DCC-Lab/HiLoZebrafish/README.md

# HiLoZebrafish
Image acquisition system for volumetric calcium imaging
