DCC-Lab/HiLoZebrafish/TODOlist/Semaine6 - 10au15 juin 2019.md

Maxence : 
  - Ajouter un polariseur entre le diffuseur et la fibre. FAIT! (MAIS il est rayé donc on devra le remplacer)
  - Aligner l'illumination. FAIT!
  - Vérifier ce qui ne fonctionne pas avec le code à Dan (Pourquoi on arrive pas aux mêmes chiffres? Est-ce qu'il nous manque des infos?) 
  - Est-ce que le diffuseur a un angle assez grand pour couvrir tout le champ de vue? Diffuseur N-BK7 a un angle d'environ 5 degrés (FWHM). Caractériser le diffuseur (Diffuser transmission VS Output Angle)
  - Comparer des images prises avec un diffuseur de 600 et 1500 grits.
  - Comparer l'illumination entre différentes distances entre la fibre et le diffuseur. Faire un graphe. (si possible)
  - Images de billes fluorescentes 
  - Optimiser le couplage entre le faisceau laser et la fibre multimode FAIT!

Valérie : 
  - Rassembler les informations sur le *Laser Speckle Remover* d'Optotune. Faire un document récapitulatif. Pas fait de document, mais la lecture est faite. 
  - Lire le code à Guillaume.
  - Investiguer sur l'apparence des images sur Nirvana VS sur Fiji #isjustImageJ qui n'est pas la même. FAIT! 
  - Aller prendre sa photo pour sa carte d'accès. FAIT!
  - Acheter deux polariseurs FAIT!
  - Lire sur la TF (Documents à Max) FAIT!
  
Lectures : 
  - Miniaturized Laser Speckle Reducer OEM Series : https://www.optotune.com/images/products/Optotune%20LSR-OEM.pdf
  - Application note, Laser speckle reduction with Optotune’s laser speckle reducer LSR-3000 & LSR-OEM : https://www.optotune.com/images/products/Optotune%20application%20note%20LSR.pdf
  - Dynamic speckle illumination microscopy with translated versus randomized speckle patterns, Jerome Mertz
