DCC-Lab/HiLoZebrafish/TODOlist/Semaine4-27mai2019.md

À COMMANDER : (VPN)
  - EXFO 810-00032 Collimating adaptor S/N : DH1437
  
TODO :
 - Trouver la focale selon le mvt de la lentille Optotune (ML)
 - Optotune avec un diametre plus gros? Voir sur le site, rassembler les infos + lire manuel d'instructions avec les commandes and all (VPN)
 - Faire fonctionner la lentille optotune : Aller voir Steve si on peut réparer la USB len driver, trouver le cube beige dans le lab (?). Est-ce qu'on est mieux d'en commander une autre ou de faire un software maison? (VPN)
 - Essayer de patenter un excelitas maison pour commencer à regarder comment a l'air l'illumination (ML)  FAIT
 - Taponner les poissons (VPN et ML)
 - Trouver lentille divergente pour Optotune (J'ai trouvé une de f = -75 mm) + tester si la lentille fonctionne (ML)
