DCC-Lab/HiLoZebrafish/TODOlist/Semaine3-21mai2019.md

À COMMANDER : (VPN)
  - EXFO 810-00032 Collimating adaptor S/N : DH1437
  - 4 cables WilcoImaging RW1LX17-2.0 2 meter standard to mini camera to link cable. : FAIT 22 mai 2019
  - Carte (Alicja va envoyer infos) : FAIT 22 mai 2019

TODO : 
  - Laser PySerial (#PyCereal) truc (ML)
  - Abstract SN a envoyer (VPN)
  - Contrôler directions yx avec Mac (VPN)
  - Trouver la focal selon le mvt de la lentille (ML)
  - Trouver lentille divergente pour Optotune + tester (ML)
  - Optotune avec un diametre plus gros? Voir sur le site, rassembler les infos + lire manuel d'instructions avec les commandes and all (VPN)
  - Patenter l'illumination (ML)
