DCC-Lab/HiLoZebrafish/TODOlist/Semaine 15 - 12 août 2019.md

Mini setup : 
- Faire expérience sur l'angle de diffusion du diffuseur DG10-120 et DG10-220. Mettre dans un graphe avec les autres diffuseurs (DG10-600 et DG10-1500) *120 fait!!*
  - Calculer le diamètre théorique avec les NA obtenus. 
- Mesurer le diamètre et la taille moyenne des speckles selon les fibres 0.22 et 0.5 NA et les diffuseurs 120 et 1500. 
  - Modifier le setup pour avoir des lentilles plus grosses *ne fonctionne pas avec des 2 pouces, focal trop grosse*
  - Rapprocher la fibre du diffuseur, produire un spot plus petit au diffuseur. *ne fonctionne pas!*

Maxence : 
  - Présentations de 5 et 15 min à préparer (pour jeudi)
  - Commencer le rapport de stage (quoi mettre? diviser en sections?)
  - Documentations 
  - Faire d'autres images HiLo et Widefield de poisson zèbre GCaMP (demander à Vincent Boily)
  
Valérie : 
  - Finir mon affiche SN ! 
  - Je ne suis pas là mardi et mercredi

Bonne semaine :) !!

  ______________________________________________________
   Discussion des speckles avec BLiq : 
 - NA de l'objectif change la taille des speckles sur les images? 
    - Expérience : Mesurer la taille des speckles sur un échantillon de FITC en utilisant 2 objectifs de même grossissement, mais avec des NA différents 
 - Grossissement objectif change la taille des speckles sur les images?
    - Expérience : Mesurer la taille des speckles sur un échantillon de FITC en utilisant 2 objectifs de même NA, mais avec des grossissements différents.
 - Back aperture de l'objectif change la taille des speckles sur les images?
    - Expérience : Comme le diamètre du back aperture de l'objectif varie en fonction du NA et du grossissement, son influence pourra être déduite à partir des deux dernières expériences. Par contre, il est important de s'assurer que le BA des objectifs utilisés lors des expériences sont remplis.
 - Taille plus petites des speckles diminue le flickering?
    - Expérience : Prendre des images d'un échantillon de FITC et de l'échantillon de cellules de rein de Bliq à l'aide d'une fibre de NA de 0.39, de 0.5 et de 0.63. Comparer le flickering observé sur chaque stack.
 - Nombre de grits du diffuseur change le flickering? Comment il le change?
    - Expérience : Prendre des images d'un échantillon de FITC et de l'échantillon de cellules de rein de Bliq à l'aide de diffuseurs de 120, 220 et 1500 grits. Tourner les diffuseurs lors de l'expérience pour observer du flickering. Comparer ensuite le flickering observé sur chaque stack.
  
  ______________________________________________________
  À discuter avec Dan :
  
  - Que ce passe-t-il avec le LSR? Aller voir Bliq
  - Commander un autre objectif? *Une fois que les expérimentations concernant la discussion avec Bliq seront faites et analysées. En discuter avec Daniel*
      - Déterminer quels paramètres affectent la taille des speckles (NA, grossissement, Taille de la pupille d'entrée de l'objectif).
      - Déterminer quels paramètres affectent l'intensité du flickering (Taille des speckles, niveau de grit des diffuseurs).
