DCC-Lab/HiLoZebrafish/TODOlist/Semaine 12 - 22 au 26 juillet 2019.md

Maxence : 
  - Regrouper les informations sur l'optique et rédiger un document informatif. 
  - Expérience sur l'angle du diffuseur DG10-1500 et LSR-3005 : Regrouper les données en tableau, graphe... FAIT!
  - Optimiser la distance fibre-diffuseur (Uniformité vs. Intensité lumineuse à l'échantillon vs. taille des speckles)
  - Connecter le LSR à Nirvana (Par le Labjack) *voir Bertrand*
  - Fabriquer une boîte pour protéger nos yeux des réflexions indésirables du laser FAIT!
  - Graphique du spectre de transmission du LSR, mesuré avec le spectromètre d'Anaïs. FAIT!
  - Tester l'algorithme HiLo avec le même sample, mais aves deux sources d'uniformité différentes (LSR vs. Scrambler) FAIT!
  - Rergarder la grosseur des speckles avec la fibre à Bliq NA = 0.63

Valérie : 
  - Comparer la taille des speckles avec les deux diffuseurs DG10-1500 et LSR-3005. FAIT!
    - Reprendre d'autres images des speckles avec les deux diffuseurs. Meilleurs résultats statistiques! FAIT!
    - Taille théorique? *on pourrait obtenir la plus petite taille théoriqe...*
  - Comment faire l'expérience avec le spot sur le mur? *probablement qu'il va falloir refaire le setup droit*
  - Mesurer expérimentalement la résolution axiale. Comparer avec la valeur théorique (?). 
    *La résolution axiale d'un objectif est dépendante de sa résolution latérale.*
    *Plus petit objet pouvant être discernable par le système optique.*
    *Sectionnement optique ne doit pas être plus petit que la résolution axiale.* 
    *1 neurone = 4-5 um*
  - Commence dont ton affiche pour SN toi chose... 
  - Expérience sur l'illumination avec le LSR dans l'axe optique. Vérifier max gray value et curvature.  

 _______________________________________________________
 
 - Imagerie de poisson zèbre GCaMP sur le 2-photons bessel avec François. FAIT!
 - On est à boutte que Caféine ne fonctionne pas! WE NEED DELTA. FAIT!
 - Aller voir Bertrand avec notre LSR. Tester son fonctionnement. 600 ms pour s'activer! *faut parler à optotune*
 - Prendre des z-stacks avec le piezo électrique. NE SEMBLE PAS FONCTIONNER #malaise
 - Prendre des z-stacks avec le sutter motion controller de Charles. 
 - Transmission du LSR avec le potentiomètre. FAIT!
 - Commander un autre objectif? 
 
 ______________________________________________________
 Discussion des speckles avec BLiq : 
 - NA de l'objectif change la taille des speckles sur les images? 
    - Expérience : Mesurer la taille des speckles sur un échantillon de FITC en utilisant 2 objectifs de même grossissement, mais avec des NA différents 
 - Grossissement objectif change la taille des speckles sur les images?
    - Expérience : Mesurer la taille des speckles sur un échantillon de FITC en utilisant 2 objectifs de même NA, mais avec des grossissements différents.
 - Back aperture de l'objectif change la taille des speckles sur les images?
    - Expérience : Comme le diamètre du back aperture de l'objectif varie en fonction du NA et du grossissement, son influence pourra être déduite à partir des deux dernières expériences. Par contre, il est important de s'assurer que le BA des objectifs utilisés lors des expériences sont remplis.
 - Taille plus petites des speckles diminue le flickering?
    - Expérience : Prendre des images d'un échantillon de FITC et de l'échantillon de cellules de rein de Bliq à l'aide d'une fibre de NA de 0.39, de 0.5 et de 0.63. Comparer le flickering observé sur chaque stack.
 - Nombre de grits du diffuseur change le flickering? Comment il le change?
    - Expérience : Prendre des images d'un échantillon de FITC et de l'échantillon de cellules de rein de Bliq à l'aide de diffuseurs de 120, 220 et 1500 grits. Tourner les diffuseurs lors de l'expérience pour observer du flickering. Comparer ensuite le flickering observé sur chaque stack.
    
_____________________________________________________________

Rapop des 3 dernières semaines : 

  - Tailles des speckles VALÉRIE
    - Expliquerish la méthode employée
    - Résultats avec le DG10-1500 et le LSR.

  - Flickering MAXENCE
    - Pourquoi c'est un problème?
    - Montrer les deux stacks avec le scrambler et le LSR : même flickering. 
      Les causes du flickering seraient donc bouger la fibre et bouger le diffuseur. 
    - Solutions pour régler le problème. 

  - Caractérisation des diffuseurs avec différents grits MAXENCE
    - Montrer les graphes de wtv. 
    
  - Patron d'illumination VALÉRIE
    - Max gray value : Comparaison DG10-1500 VS LSR
    - Curvature : Comparaison DG10-1500 VS LSR 
    
  - Images et vidéo zebrafish BOTH
    - Vidéos d'activité calcique
    - Images HiLo
