DCC-Lab/HiLoZebrafish/TODOlist/Semaine 11 - 15 au 19 juillet 2019.md

Maxence : 
  - Regrouper les informations sur l'optique et rédiger un document informatif. 
  - Comment refaire l'expérience de l'angle du diffuseur? FAIT *avec le stage!*
  - Optimiser la distance fibre-diffuseur (Uniformité vs. Intensité lumineuse à l'échantillon vs. taille des speckles)
    - Trouver la tailles des speckles avec une simulation(?) par régression(?). FAIT !
    - Comparer la taille exprimentale des speckles avec sa valeur théorique (Taille = lambda/2NA)
  
  Valérie : 
    - C'est quoi une simulation par régression? FAIT! *Curve fit* 
    - Comment faire l'expérience avec le spot sur le mur? *probablement qu'il va falloir refaire le setup droit*
    - Mesurer expérimentalement la résolution axiale. Comparer avec la valeur théorique (?). 
    *La résolution axiale d'un objectif est dépendante de sa résolution latérale.
    Plus petit objet pouvant être discernable par le système optique. 
    Sectionnement optique ne doit pas être plus petit que la résolution axiale. 
    1 neurone = 4-5 um*
      Faire de même avec la résolution latérale. FAIT

  - Imagerie de poisson zèbre GCaMP lundi à vendredi. Faire des vidéos d'activité neuronale. 
  - Déterminer l'irradiance *parfaite* pour l'imagerie *in vivo* de poisson zèbre. 
    Utiliser des objectifs avec plus de grossissement si possible. 
    *Utilisé un 40X et le poisson n'a pas cramé. Irradiance = 354.4 mW/mm^2*
    
  Lectures : 
  
    - Statistical speckle study to characterize scattering media: use of two complementary approaches, O. Carvalho and *al*.,  
    - Speckle size, intensity and contrast measurement application in micron-size particle concentration assessment, Dan Chicea
    - Methods for Determination of Mean Speckle Size in Simulated Speckle Pattern, I. Hamarava and *al*.,
    
  Bonne semaine :)!!
