DCC-Lab/HiLoZebrafish/TODOlist/Semaine10 - 8 au 12 juillet 2019.md

Maxence :
  - Regrouper les informations sur l'optique du microscope et rédiger un document informatif.
  - Vérifier ce qui ne fonctionne pas avec le code à Dan (Pourquoi on arrive pas aux mêmes chiffres? Est-ce qu'il nous manque des infos?)
  - Est-ce que le diffuseur a un angle assez grand pour couvrir tout le champ de vue? *Caractériser le diffuseur (Diffuser transmission VS Output Angle) *Recommencer l'expérience faite avec un écran blanc, mon téléphone et une règle pour plusieurs distances diffuseur-écran.* FAIT! Les résultats montre que l'expérience ne fonctionne probablement pas
  - Comparer des images prises avec des diffuseurs de 120, 240, 600 et 1500 grits quand on les reçoit. FAIT! *Reste plus qu'à voir qu'est-ce qu'on peut en tirer
  - Optimiser la distance fibre-diffuseur (Uniformité vs. Intensité lumineuse à l'échantillon vs. Taille des speckles)
    - Trouver la taille des speckles avec une simulation par régression *quoi? pardon?*
    - Caractériser/Trouver les speckles avec un objectif 40X/60X etc.
  - Image poisson avec un objectif plus gros, permet d'augmenter (40X) l'irradiance. Déterminer l'irradiance ''parfaite'' pour l'imagerie *in vivo*. *Semaine prochaine!*
  
Valérie : 
  - Faire un film d'activité neuronale d'un plan dans un zebra vivant. 
  *Penser essayer avec le 20X et le 40X. Semaine prochaine!*
  - Faire l'expérience sur la grosseur du spot au mur 
  *Ne fonctionne pas en mettant un miroir pour faire dévier le beam, car beam trop gros. On doit le garder droit. Comment faire un set-up stable?*
  - Mesurer expérimentalement la résolution latérale et axiale. Latérale = FAIT!
  - Faire une slide de beads fluorescents pour mesurer les objets dans nos images + scalebar. FAIT! 
  - Extraire le maximum des données de curvature. FAIT! 
  *Mais il n'y a pas de plateau... comment interpréter ces résultats? Déterminer la distance optimale aussi avec la grosseur optimale de speckles ; pas juste avec la puissance à l'échantillon. Quelle sectionnement optique est l'idéal?*

Bonne semaine! :)
