DCC-Lab/HiLoZebrafish/TODOlist/Semaine8 - 25 au 28 juin 2019.md

Maxence :

- Vérifier ce qui ne fonctionne pas avec le code à Dan (Pourquoi on arrive pas aux mêmes chiffres? Est-ce qu'il nous manque des infos?)
- Est-ce que le diffuseur a un angle assez grand pour couvrir tout le champ de vue? Diffuseur N-BK7 a un angle d'environ 5 degrés (FWHM). Caractériser le diffuseur (Diffuser transmission VS Output Angle) (L'expérimentation est faite, voir avec Daniel si elle est assez rigoureuse)
- Comparer des images prises avec des diffuseurs de 120, 240, 600 et 1500 grits.
- Optimiser la distance fibre-diffuseur (Uniformité VS Intensité lumineuse à l'échantillon)
- Commander le piezo. (Le message a été envoyé à Daniel, car Julie est en congé)
- Voir avec Vincent, Radu et Gabriel : Quelle puissance utilise-t-il avec leur 2ph pour imager? Peut-être qu'on a besoin de plus de puissance finalement... (Microscope with illuminator HXP 120V => ~ 14.41 mW at the sample)
- Réussir à se connecter à cafeine2

Valérie :

- Ajouter une lentille pour observer l'image de la source lumineuse au diffuseur. Obtenir le diamètre de la source. 
- Pourquoi on a autant d'artifact de fluorescence dans les images de zebrafish? Investiguer... 
- Vérifier les filtres. Peut-être qu'ils n'ont pas une bonne transmissivité ou wtv. (En effet, on a besoin d'un autre filtre! Changé pour le D545\90)
- Refaire l'expérience de la distance entre le diffuseur et la fibre avec moins d'exposure time (avec et sans polariseur). Faire un curvefit éllipse et vérifier la pente de la courbe. Pente élevée = illumination moins uniforme. (Pas si évident que ça à voir dans les courbes de slopes d'illumination. Comment faire pour savoir quelle est la bonne distance?)
- Scalebar avec des billes de 1um! (Faut refaire une lame de billes, car les billes sont en agrégats sur notre lame.)
- Vérifier des images de poissons sans binner et en intégrant plus longtemps pour avoir des neurones plus définis. Aussi, comparer les images prises avec et sans speckle. Jusqu'à maintenant, les images étaient toujours prises avec speckle! (Pas évident de voir la différence entre les deux images...)
- Faire une présentation pour Jeudi FAIT!
