DCC-Lab/HiLoZebrafish/TODOlist/Semaine7 - 17 au 21 juin 2019.md

Maxence : 
  - Vérifier ce qui ne fonctionne pas avec le code à Dan (Pourquoi on arrive pas aux mêmes chiffres? Est-ce qu'il nous manque des infos?)
  - Est-ce que le diffuseur a un angle assez grand pour couvrir tout le champ de vue? Diffuseur N-BK7 a un angle d'environ 5 degrés (FWHM). Caractériser le diffuseur (Diffuser transmission VS Output Angle)
  - Comparer des images prises avec un diffuseur de 600 et 1500 grits et les autres grids
  - Investiguer pourquoi il y a autant de pertes au diffuseur et au polariseur FAIT!
  - Voir si l'adapteur (nose-piece) de l'objectif fait en sorte que l'on perd de la puissance FAIT!
  
Valérie : 
  - Faire fonctionner le stage avec le software. FAIT! 
  - Commander les autres grids FAIT! 
  - Comparer l'illumination entre différentes distances entre la fibre et le diffuseur. Faire un graphe. (si possible)
  
Lecture : 
  - Optimizing and extending light-sculpting microscopy for fast functional imaging in neuroscience (2015)
  
IMAGE POISSON :)
