DCC-Lab/HiLoZebrafish/TODOlist/Semaine2-16mai2019.md

À COMMANDER (VPN) :
  - diffuseur DG10-1500 : https://www.thorlabs.com/thorproduct.cfm?partnumber=DG10-1500 Fait!
  - objectif UMPLFN 20X : https://www.olympus-lifescience.com/en/objectives/lumplfln-w/#!cms[tab]=%2Fobjectives%2Flumplfln-w%2F20xw Fait!
  - Olympus U-TLU + U-CMAD3 + U-TV1X-2 : Adaptateur pour le BX51 et la cam Orcaflash : Fait!
  - Thunderbolt 3 à 2 apple : Fait! 

À TROUVER (ML) : 
  - Caméra Orcaflash : Fait! Chez Bliq
  - Adapteur pour BX51 (on aurait juste besoin d'un diffuseur? voir mardi et mercredi prochain avec Alicja)
  - Power supply pour la boîte d'acquisition : Fait! Est sur la table optique.
  - Camera link bouts gros et petit : Fait! 

TO-DO : 
  - Abstract SN affiche (VPN)
  - Comprendre git (VPN et ML) : ok
  - Demain 17 mai 2019 : Trouver les À TROUVER, aller voir Benoit chez Bliq (ML)
  - Jouer avec le code de l'illuminateur et vérifier qu'on a toutes les lens (ML). FOV = 600 X 600 X 300
    - Semaine prochaine : Concevoir l'illuminateur (ML)
  - Vérifier le code MatLab à François pour le scrambler (code sur Git) (ML)
  - Contrôler directions xy avec ordi (VPN)
  - Comment contrôler la lentille et rassembler des infos sur la lentille (VPN)
  - Trouver le f selon le mouvement de la lentille (ML)
  - Semaine prochaine : Synchroniser l'acquisition et le mouvement de la lentille/vérifier comment l'acquisition se fait avec Nirvana (parler à François pour installer Nirvana sur l'ordi en-bas)
    (VPN et ML)
