DCC-Lab/HiLoZebrafish/MarcStageEte2023/cahier_de_lab/week2/20230511/20230511.md

# Présence en laboratoire le 11 mai

## Expérience 1

## But principal

___

Le but de cette présence en laboratoire était de mesurer la taille moyenne des *speckles* avec le microscope HiLo pour caractériser leurs tailles en fonction de la taille de l'image prise. Nous voulions savoir si le critère de Nyquist était respecté pour ces différentes tailles. Nous avons mesurés leur taille en pixel pour les tailles d'images suivantes: 2048x2048, 1024x1024 et 512x512. L'échantillon sur lequel les mesures furent prises fut un tapis de billes fluorescentes.

## Matériel

___

- La caméra utilisée est la ORCAFlash4.0 V3 - C13440-20CU, une caméra digitale CMOS de *Hamamatsu*. Les notes techniques sont disponibles [ici](https://www.hamamatsu.com/content/dam/hamamatsu-photonics/sites/documents/99_SALES_LIBRARY/sys/SCAS0134E_C13440-20CU_tec.pdf) et le manuel d'instruction [ici](https://seltokphotonics.com/upload/iblock/d68/d6870f763aa81b7b8f2c0853b7e20782.pdf)

- Le logiciel qui permet de contrôler la prise d'image et les différents paramètres de la caméra est: *NirvanaS* (2.4.1). Les différentes fenêtres et options qui seront utiles dans cette expérience sont expliquées dans un guide pour l'utilisation du microscope HiLo disponible [ici](fakelien.com).

- Un laser pour permettre la fluorescence et donc la possibilité de visionnement d'image. On utilise le *Cobolt* 06-MLD 488nm de *HÜBNER Photonics*. La *data sheet* est disponible [ici](https://hubner-photonics.com/wp-content/uploads/2014/11/D0352-O-Datasheet-Cobolt-06-01-Series.pdf) et l'explication de son utilisation avec notre système optique ce trouve [ici](fakelien.com).

- Lame et lamelle de microscopie

- Vernis à ongle

- Pipette volumétrique P200 et P20 avec les embouts leurs correspondant.

- Solution contenant les billes fluorescenctes: *Rhodamin 6G* (RG6).

- Eau distillée (Milli-Q)

## Méthode

___

Cette expérience sera divisée en 3 étapes distinctes:

- $(1)$ **Premièrement**: Préparer des échantillons de bille fluorescente (RG6) pour pouvoir observer la taille des *speckles* sur ceux-ci.

- $(2)$ **Deuxièmement**: À différentes tailles d'images, prendre une photo de l'échantillon de RG6 préparé pour pouvoir analyser ces images numériquement et en tirer la taille des *speckles* par la suite.

- $(3)$ **Finalement**: Utiliser les images prises pour estimer numériquement la taille des *speckles* en fonction de la tailles des images pour pouvoir savoir si la taille des *speckles* respecte toujours le critère de Nyquist.

## Déroulement

___
Étape $(1)$:

- Méthode prise:

  La méthode pour préparer les échantillons est celle qui est expliqué dans la *repository GitHub* [suivante](https://github.com/DCC-Lab/Documentation/tree/master) sous le dossier *HOWTO* -> *.HOWTO-MeasureMeanSpeckleWidthOnInFocusImagesOfSpeckles.pdf*. Dans ce document, seule la partie de préparation d'échantillon nous intéresse.

  Dans notre cas, la solution de bille que l'on utilise est de la *Rhodamin 6G* (RG6) diluée 2 fois avec de l'eau distillée Milli-Q. On a donc préparé une solution contenant $400 \mu L$ de *RG6* et $400 \mu L$ de Milli-Q. Par contre, sur la lamelle, on a seulement déposé 2 fois $20\mu L$ de cette solution, donc $40\mu L$.

Étape $(2)$:

- Branchement des différents appareils utilisés:

  Comme d'habitude, on ouvre le système de microscopie HiLo suivant le guide donné plus haut dans la section **Matériel**.
  
  Dans le cas de cette expérience, le changement de focale se fera en bougeant manuellement le *stage* qui tiens l'échantillon en place.

- Setup logiciel:

  Le setup logiciel de cette expérience est selon la procédure standard, toujours expliqué dans le guide HiLo.
  
  Dans le cas de cette expérience, rien n'est différent du guide, mis-à-part le fait que l'on doit s'assurer d'avoir le module *TimeLapse* ouvert, car il s'avèrera grandement utile pour une prise des données rapide.

- Méthode prise:

  La taille des *speckles* se calcule uniquement au plan focal de l'échantillon. On doit donc prendre une image à ce plan focal pour obtenir une dimension réaliste. Par contre, ce plan focal est arbitraire, car on le détermine simplement à l'oeil. Pour s'affranchir de ce problème, on peut prendre plusieurs images autour de ce qu'on pense être le plan focal et réaliser l'analyse de la taille des *speckles* pour chacune de ces images. Alors, la taille effective des ces *speckles* sera la valeur obtenue la plus petite, car elle se situera nécéssairement au plan focal.

  Les différentes images qui seront intéressante pour cette expérience sont les suivantes: pour chaque résolution, on veut 10 images de différents plans autour du plan focal, par exemple 5 plus haute que le plan focale et 5 plus basse que le plan focal, en s'assurant qu'elles sont faiblement spatialement espacées (dans notre cas chaque image est espacée de $2 \mu m$). Par la suite, pour déterminer la taille des speckles, on doit aussi prendre une image uniforme et une image speckle pour chaque plan choisi. Cela fait donc 20 images par taille d'image et donc 60 images en tout.

  Pour s'y prendre, on commence par choisir la première résolution. On détermine à l'oeil ce qu'on pense être le plan focal et par la suite on descend (ou monte) le stage 5 plans plus haut. Dans notre cas, on monte le stage $10 \mu m$ plus haut. Ensuite, en commençant pas le mode uniforme par exemple, on prend 10 images en descendant le stage de 10 plans. On refait alors la même chose pour la même taille d'image, mais en changeant pour des images *speckles*. On a alors les 20 images pour la première taille d'image. Finalement, il suffit de refaire la même chose pour les autres tailles d'images.

  Il est bien important d'aller le plus vite possible pour prendre ces photos, car le *photo-bleaching* de la zone étudié est assez rapide. Dans notre cas, pour s'aider, nous avons utilisé un *TimeLapse* de 10 images chacune espacée de 2 secondes, nous laissant le temps de manuellement changer la hauteur du stage entre chaque image (il est préférable d'être deux pour que ces manipulations soit encore plus facile à réaliser).

  Les paramètres choisis pour l'expérience sont les suivants:

  - 2048x2048:

    - Temps d'exposition: 150ms

    - Puissance du laser: 80mW

    - Balayage de hauteur du plateau: $1590-1610 \mu m$

  - 1024x1024:

    - Temps d'exposition: 150ms

    - Puissance du laser: 80mW

    - Balayage de hauteur du plateau: $1580-1600 \mu m$

  - 512x512:

    - Temps d'exposition: 150ms

    - Puissance du laser: 50mW

    - Balayage de hauteur du plateau: $1580-1600 \mu m$

- Résultat:

  Les résultats des images obtenues sont tous contenues dans le serveur *cafeine3* sous l'arbre suivant:
  
  - *Goliath* -> *maroy* -> *HiLo* -> 20230511-*MeasuringSpeckleSize*

Étape $(3)$:

- Setup logiciel:

  Pour réussir l'analyse des données et obtenir la taille des speckles en fonction de la résolution, on analysera les données en utilisant le language de programmation *Python*. Dans ce même *repository*, le code utilisé pour analyser ces donnée est [ici](https://github.com/Infinit-Dream/dcclab_t3stage_cervo_HiLo/blob/main/data_analysis/week2/20230511/speckle_sub_uniform.py).

- Méthode:

  Le code utilise une méthode de calcul assez pointu pour la taille des *speckles* et la documentation ainsi que le code expliquant le fonctionnement derrière cette méthode de calcul est indiquée dans la [thèse de mémoire de Valérie Pineau Noël](https://corpus.ulaval.ca/entities/publication/8669e044-b6d9-4ee4-a4a4-651028a000d3), sous la section 2.1 The Kohler condition.

  Un script adapté pour cette expérience a été construit en se basant sur le code indiqué dans la thèse de Valérie, permettant de simplement fournir deux stacks d'image en .tiff: le stack *speckle* et le stack uniforme. Le code retourne alors un fichier *.csv* contenant les tailles des *speckles* pour chaque couple d'image *speckle*-uniforme fournis dans les stacks.
  
- Résultat:

  Le résultat principal que l'on tire de cette expérience est le suivant: un binning 4x donnant une résolution de 512x512 n'est pas optimal pour l'imagerie HiLo, puisque l'on obtient une taille moyenne de *speckles* d'environ 2 pixels. Cette taille ne respecte alors pas le critère de Nyquist, qui requiert au moins 3 pixels, nous n'avons donc pas assez de résolution pour un *speckle*.

  Pour les deux autres résolutions, 2048x2048 et 1024x1024, nous obtenons une taille moyenne de *speckle* d'environ 4 et 7.5 pixels respectivement. Cela est donc amplement suffisant pour l'imagerie. Par contre, nous allors fort probablement choisir une taille d'image de 1024x1024 pour réaliser des images HiLo du au fait que le buffering de la caméra devient un obstacle à trop haute résolution. En effet, plusieurs images sont perdues lorsque nous réalisons leurs prises à 2048x2048, car la taille des images trop importante ne permet pas à l'ordinateur de tout enregistrer en suivant la vitesse de la caméra. En revanche, ce problème ne survient pas à 1024x1024.

  Tout les fichiers .csv contenant les data de ces résultats expliqués ici sont disponible [ici](https://github.com/Infinit-Dream/dcclab_t3stage_cervo_HiLo/tree/main/data_analysis/week2/20230511/data).
