DCC-Lab/HiLoZebrafish/MarcStageEte2023/data_analysis/week2/20230511/data/binning2_speckle/20230511-Rhodamin6G-80m-Binning2x-150msExp-1580-1600um-Speckle-001-Orca flash-Ch-1-TimeLapse_1-Time_0.081s-Frame_000000.tif

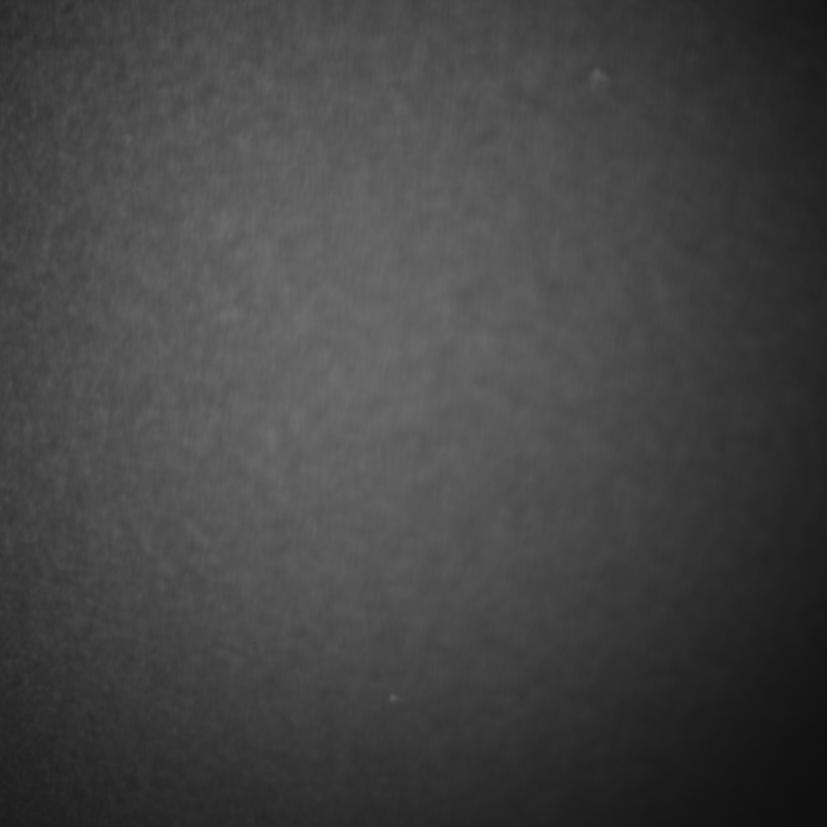
MarcStageEte2023/data_analysis/week2/20230511/data/binning2_speckle/20230511-Rhodamin6G-80m-Binning2x-150msExp-1580-1600um-Speckle-001-Orca flash-Ch-1-TimeLapse_1-Time_0.081s-Frame_000000.tif
