DCC-Lab/HiLoZebrafish/MarcStageEte2023/data_analysis/week2/20230511/data/binning2_substract/substracted_im_5.tiff

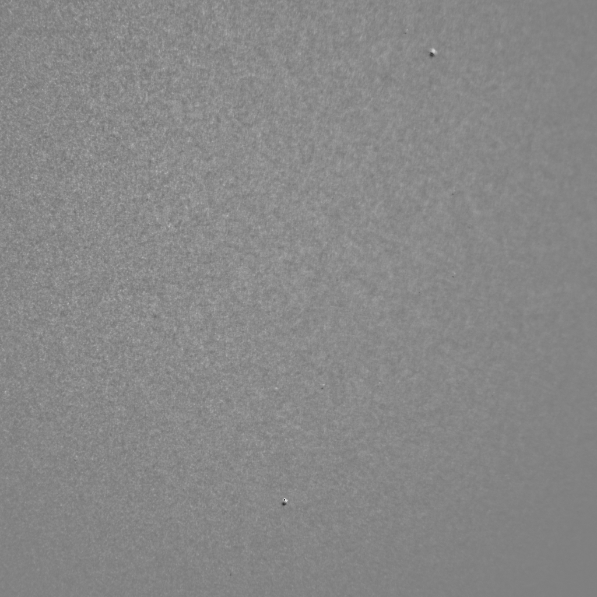
MarcStageEte2023/data_analysis/week2/20230511/data/binning2_substract/substracted_im_5.tiff
