DCC-Lab/HiLoZebrafish/MarcStageEte2023/data_analysis/week2/20230511/data/binning4_substract/substracted_im_0.tiff

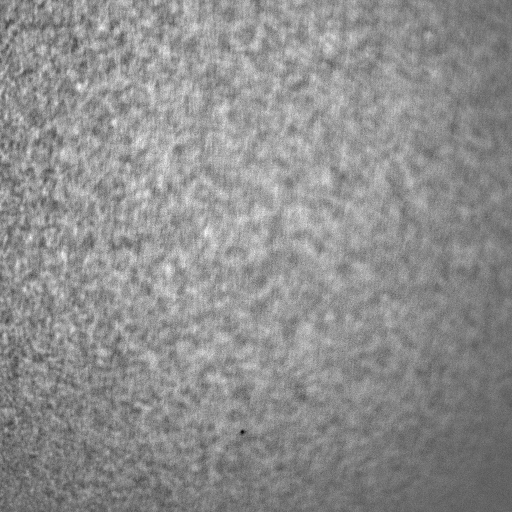
MarcStageEte2023/data_analysis/week2/20230511/data/binning4_substract/substracted_im_0.tiff
