DCC-Lab/HiLoZebrafish/SpeckleSizeCode/MATLAB/20190924-200ms_20mW_Ave15_Gray_10X0.4_8.tif

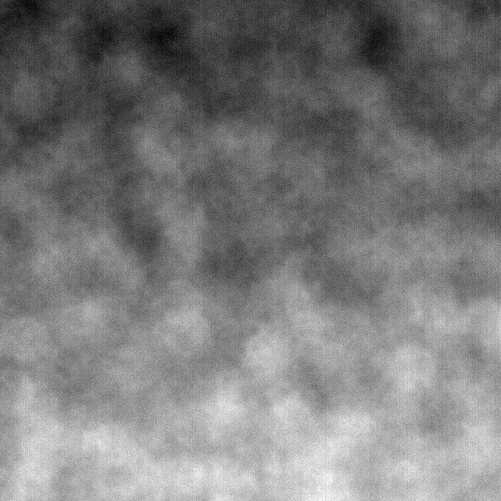
SpeckleSizeCode/MATLAB/20190924-200ms_20mW_Ave15_Gray_10X0.4_8.tif
