DCC-Lab/HiLoZebrafish/SpeckleSizeCode/MATLAB/speckle0.tiff

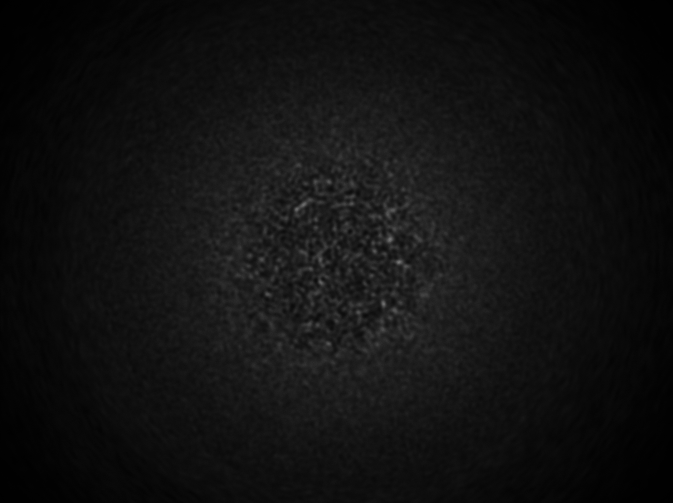
SpeckleSizeCode/MATLAB/speckle0.tiff
