DCC-Lab/HiLoZebrafish/SpeckleSizeCode/MATLAB/speckle1pouce_12ms.jpg

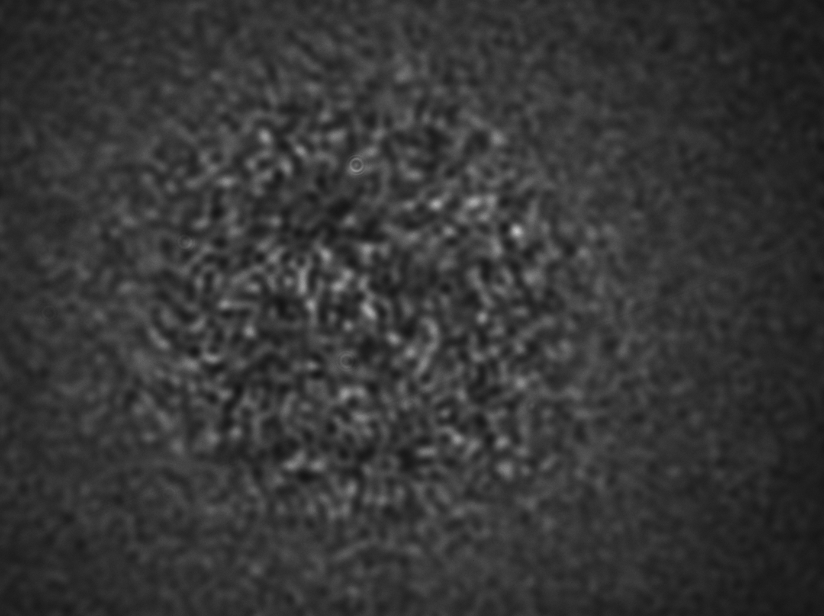
SpeckleSizeCode/MATLAB/speckle1pouce_12ms.jpg
