DCC-Lab/HiLoZebrafish/SpeckleSizeCode/MATLAB/speckle2pouces_30ms.jpg

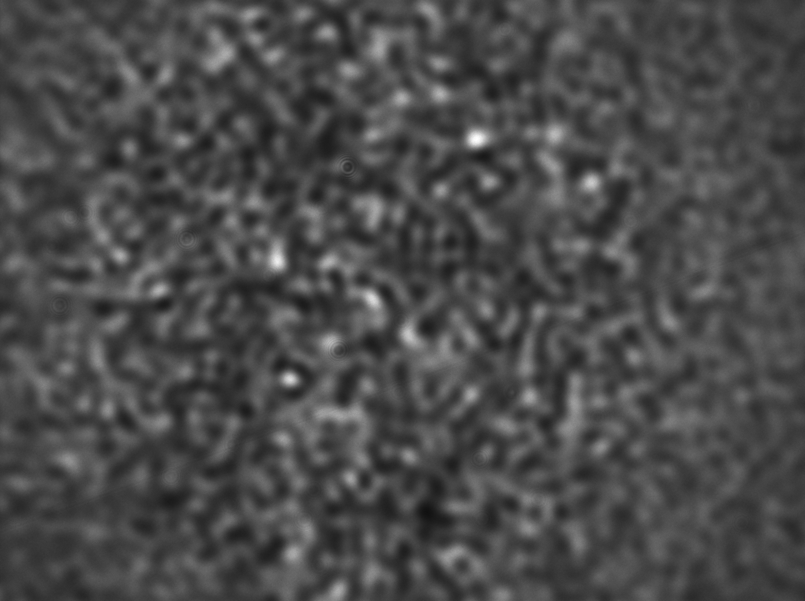
SpeckleSizeCode/MATLAB/speckle2pouces_30ms.jpg
