DCC-Lab/HiLoZebrafish/(commit log)

2019-05-16 Test de commit
2019-05-16 Test de commit 2.0
2019-05-17 Modification de l'objectif ; W.D., focale de la lentille habituellement utilisée avec l'objectif, grossissement et F.N.
2019-05-22 add lecture tunable lens + 2photons
2019-05-27 Added illuminationFromSourceWithOptotune and illuminationFromObjectiveToCamera
    The choice of the focal length of the tube lens still needs to be done.
2019-05-28 Modified camera's characteristics
2019-05-29 Added illumination with optotune AND divergent lens
2019-05-29 Add Lecture Volumetric HiLo with Optotune lens
2019-06-03 Small ajustments to stay consistent with the 40 mm focal
2019-06-11 Add Guillaume's code for Optotune lens
2019-06-18 Make the stage Zaber work DONE
2019-07-02 Added GFP filter 500-590
2019-07-02 Added excitation filter transmission spectrum
2019-07-19 Add data from the powermeter experiment and the python script to plot Diffuser transmission vs. output angle
2019-07-30 Add transmission vs output angle with power meter graphs
2019-08-01 Added DG10-600 data from power meter
2019-08-12 Add comments in code PowerExperimentDG1500AndSpeckleRemover.py
2019-08-12 calculations on PowermeterExperimentDG1500AndSpeckleRemover.py
2021-07-27 Add Arduino code for ETL
2023-05-17 Merged all things from my private repo to this repo
    [binning1_substract_speckles_info.csv, binning2_substract_speckles_info.csv, binning4_substract_speckles_info.csv]
2023-07-06 J'ai ajouté une nouvelle expérience dans mon cahier de laboratoire, celle du 2023-06-22.
2023-08-04 Modified the Arduino loop, now it takes a dummy image at the start to compensate for the slow mechanical effect of the ETL when the displacement is too big.
    [LoopCommandInHiLoSparq.ino]
